TYF009/Mini-Printer/docs/en/index.md

# FOLI documentation

[简体中文](../zh-CN/index.md) · [Product overview](../../README.md)

| Guide | Purpose |
|---|---|
| [Get started](getting-started.md) | Explore the app, build software and prepare a compatible printer |
| [System architecture](architecture.md) | Follow layout, raster bytes, BLE, firmware and paper |
| [Mechanical and assembly](assembly.md) | Obtain printable parts and identify missing manufacturing details |
| [Verification](verification.md) | Understand recorded results and remaining integration limits |
| [Product case study](product-case-study.md) | See concrete product/engineering decisions and tradeoffs |
| [Sources and media](provenance.md) | Separate new work, inherited materials, visualization and evidence |

The older Chinese module notes in the parent documentation directory are retained as historical technical references. When they disagree with selected source files or the current verification record, resolve the discrepancy rather than assuming the newest-looking prose is correct.
