TYF009/Mini-Printer/docs/zh-CN/index.md

# FOLI 文档导航

[English](../en/index.md) · [产品首页](../../README.zh-CN.md)

| 文档 | 内容 |
|---|---|
| [开始使用](getting-started.md) | 体验 App、构建软件、准备兼容打印机 |
| [系统架构](architecture.md) | 排版、光栅、BLE、固件到纸张的链路 |
| [机械与装配](assembly.md) | 打印件、装配参考和待记录制造信息 |
| [验证范围](verification.md) | 已观察结果及尚未解决的联调边界 |
| [产品案例](product-case-study.md) | 具体产品／工程判断与取舍 |
| [来源与媒体](provenance.md) | 区分新增实现、既有资料、概念视觉和真实证据 |

上级目录的旧中文模块文档保留为历史技术参考。与选定源码或当前验证记录冲突时应核实差异，不能仅按文字更新时间判断正确性。
