TYF009/Mini-Printer/docs/03-软件设计/07-步进电机.md

# 03-软件设计 · 07 · 步进电机驱动

## 1. 需求

打印机逐行成像：打完一行 → 电机拖纸前进一个行高 → 打下一行 → 循环至整幅完成。走纸精度直接决定行距一致性（=图像纵向分辨率），所以用**步进电机**（开环精确定位），机芯电机为两相四线、额定 3.5~8.5V，由 TC1508S 双 H 桥驱动（硬件见 02-硬件设计/04）。

## 2. 步进原理：四相八拍

两相步进电机按励磁顺序通电，转子以固定步距角转动。本项目用**四相八拍（半步）**序列——把两相线圈按 8 状态循环励磁（A→AB→B→BC→C→CD→D→DA），每拍步距角为整步的一半：

```c
// em_motor.cpp：8 状态 × 4 引脚查表（INA/INB/INC/IND）
static const uint8_t step_table[8][4] = { {1,0,0,0},{1,1,0,0},{0,1,0,0},{0,1,1,0},
                                          {0,0,1,0},{0,0,1,1},{0,0,0,1},{1,0,0,1} };
```

每发一拍，依次把表项写到 4 个 IO 上，并保持足够的相稳定时间（本项目 2ms 节拍）。查表法把励磁序列固化，逻辑清晰且换向只需反转查表方向。

## 3. 走纸与打印的几何关系

- 步进电机每前进一步，纸张前进 **0.0625mm**
- **每 4 步 = 一个打印点的行高**（结构参数：4 × 0.0625 = 0.25mm 行距，对应 384 点热敏头的纵向 DPI）
- 所以"打印一行走一行"在代码里就是：每打完一行 `motor_step(4)`

## 4. 两种驱动方式（em_motor.cpp 提供）

| 方式 | 实现 | 场景 |
|---|---|---|
| Ticker 中断步进 | 2ms 定时器回调里走一拍 | 长按连续走纸（不阻塞按键扫描） |
| 同步步进 | 循环内逐拍走 + 相间延时 | 打印行间隙走纸（与打印时序强同步） |

打印时用同步方式（一行打完必须精确走 4 步再打下一行，时序强耦合）；用户手动走纸用中断方式（响应连续运转且不卡其他任务）。打印结束后固件还会连续走纸 230 步（~14mm）做"出纸收尾"，方便撕取。
