TYF009/Mini-Printer/docs/zh-CN/product-case-study.md

# FOLI：把完整产品讲清楚

[English](../en/product-case-study.md) · [文档导航](index.md)

FOLI 围绕已有 Mini-Printer 实物平台，建立英文优先的产品体验，将真实控制板与打印机构、嵌入式固件、现有外壳设计和新原生 Android App 连接起来。展示重点是跨软硬件的产品判断，并让别人能够理解与复现。

## 一个具体场景贯穿系统

键盘旁的一张清单便能串起整条链路：选模板、改文字、查看黑白效果、连接并发送、把纸条放在手边。礼物留言与随身清单复用相同能力，不依赖云端账号或复杂内容服务。

暖白、薄荷与纸面编辑器建立统一视觉。生活概念图表达预期体验，真实硬件照片说明电路与纸面输出确实存在；两类素材承担不同证据作用。

## 决策一：预览真正准备发送的内容

装饰预览可能很好看，却掩盖阈值、抖动和行宽造成的输出变化。FOLI 编码出 384 点光栅，再根据编码结果生成预览，使用户查看的是准备发送的数据表示。

代价是内容有界限，也确实需要处理时间。`PrinterProtocol` 检查宽度与行数，`PaperRenderer` 负责排版。生成下一次预览时保留上一张纸面，避免编辑区变空。实现见[系统架构](architecture.md)和 [Android 源码](../../software/android/app/src/main/java/studio/foli/android/)。

## 决策二：用旧手机暴露真实布局问题

小米 6 暴露了桌面大屏效果图看不到的问题：键盘挡住操作、复选框细线在二值化后缺失、反馈提示让编辑区域移动。实现因此采用全屏文字编辑、明确的复选框几何和不挤压纸面的反馈。

模板筛选、本地收藏、大预览、Cancel／Undo 与滚动位置保留减少了重复寻找上下文。它们是已实现的功能，并有部分真机观察；这不代表已经测得动画 FPS 或完成用户研究。实际检查范围见[验证记录](verification.md)。

## 决策三：把不确定当作产品状态

蓝牙连接、发送成功和打印完成不是同一事件。继承协议的端到端证据有限，因此 FOLI 分别显示传输与打印状态。即便观察到开始到终态的完整序列，也仅判为 STOPPED_UNCONFIRMED，因为状态3还可能表示异常停止。应用提示检查纸张，并在下一任务前重启打印机后明确确认，阻止盲目重发部分接收内容。

不确定传输后可能需要用户明确重启打印机。这不如自动重试方便，但在协议无法证明已打印内容时，可以避免悄悄重复或破坏实体任务。固件修复与未来协议升级也应维持这一区分。

## 仓库工作与成果边界

FOLI 阶段工作包括原生 Android 体验、模板编辑交互、光栅／协议整合、品牌、产品可视化和工程文档整合。已有硬件、固件与机械基础保留来源上下文。购买授权、上游作者与新增实现分别见[来源说明](provenance.md)。

项目按开发状态发布：有历史实物打印，有 App 交互与协议测试；没有重复验证全部更新组件的端到端纸面输出。下一步有价值的证据是最终整机照片、制造参数和版本化联调记录，而非虚构速度、耐久或量产成熟度。
