TYF009/Mini-Printer/docs/images/pcb-3d-bottom.png

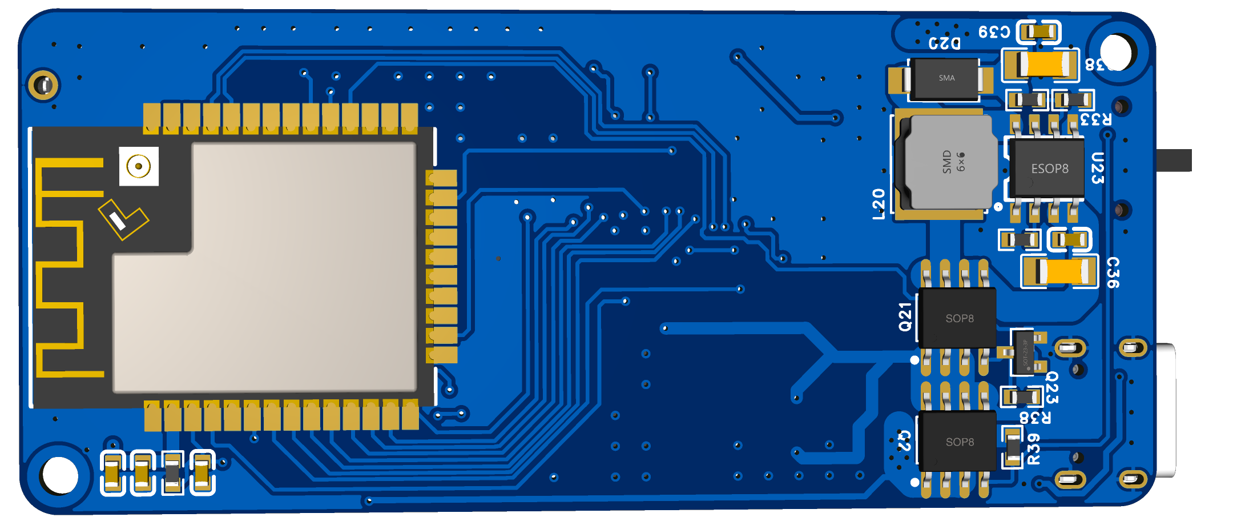
docs/images/pcb-3d-bottom.png
