TYF009/Mini-Printer/docs/images/pcb-3d-top.png

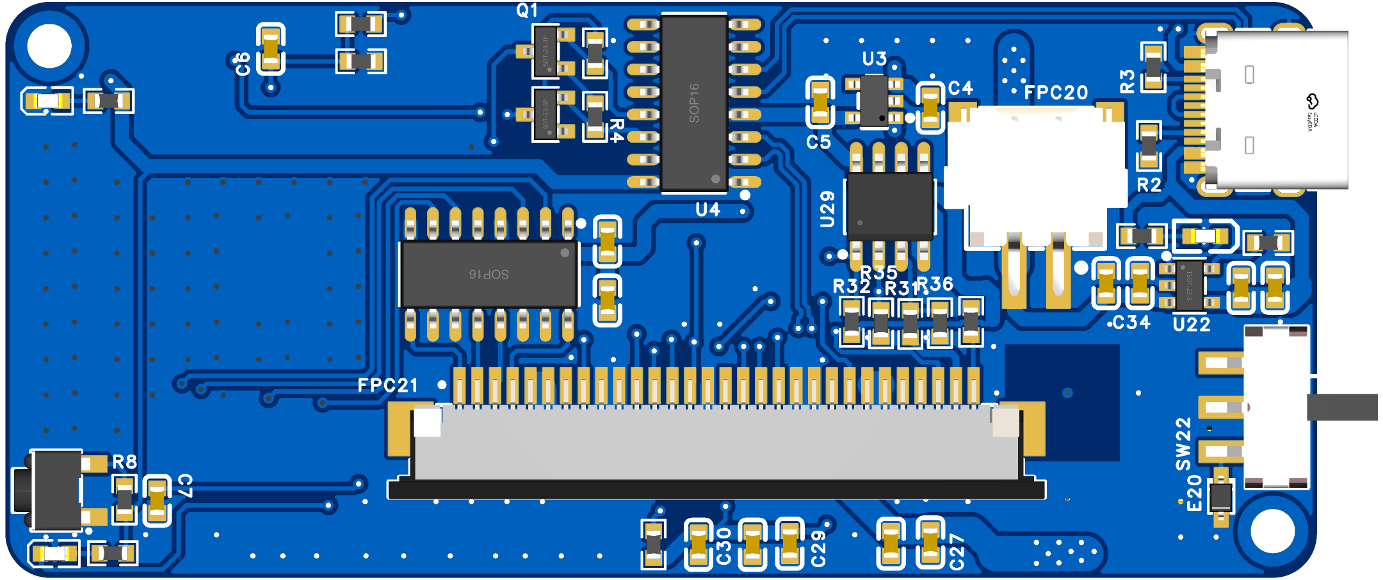
docs/images/pcb-3d-top.png
