TYF009/Mini-Printer/hardware/EDA-project/exports/schematic.png

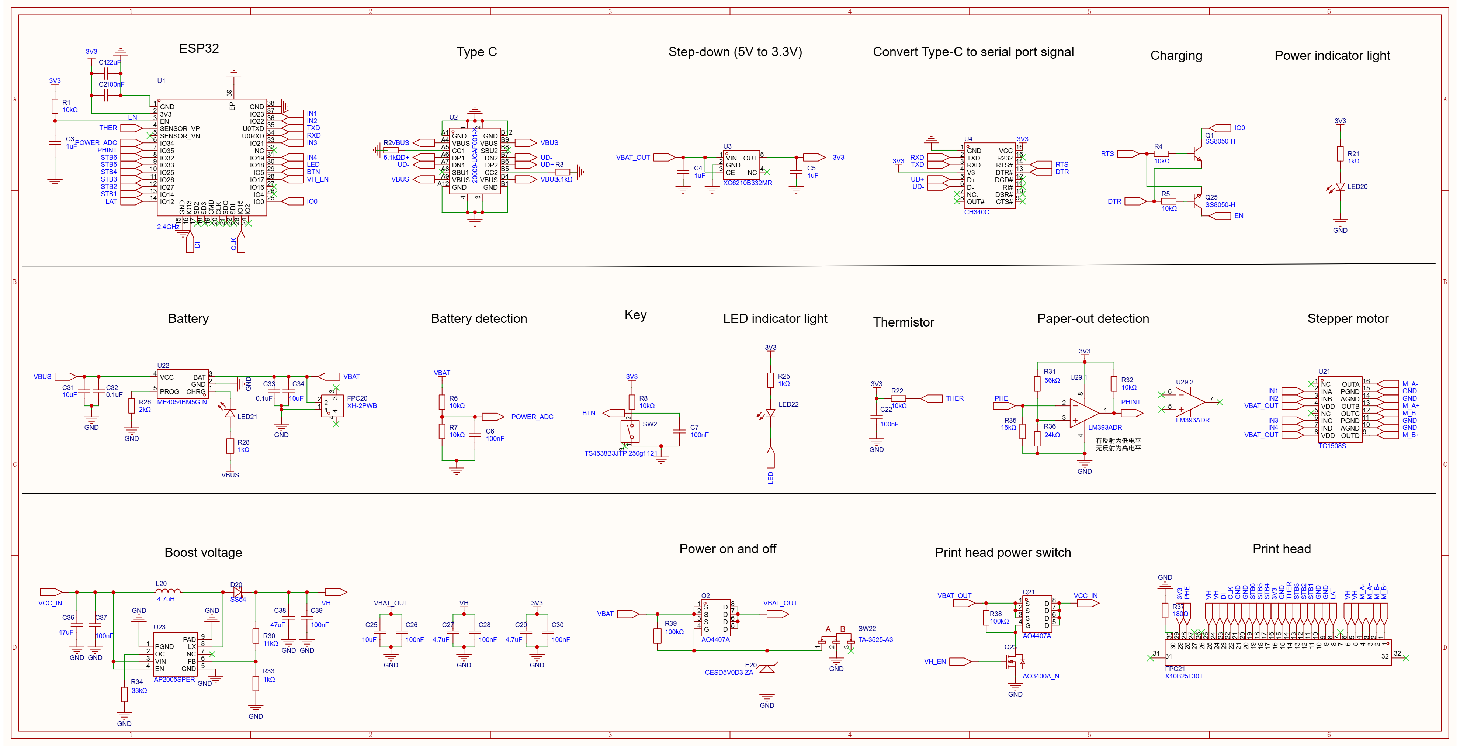
hardware/EDA-project/exports/schematic.png
