TYF009/Mini-Printer/media/gifs/screen-to-paper.gif

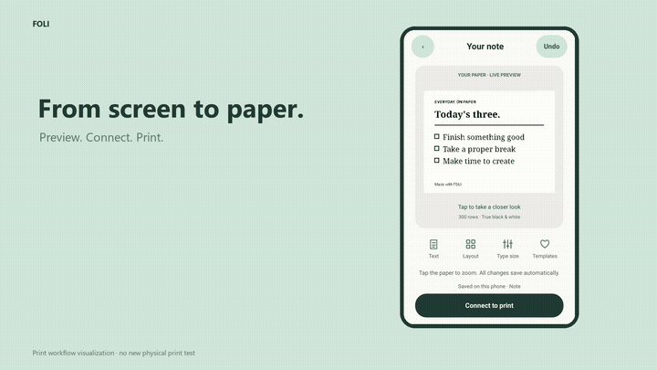
media/gifs/screen-to-paper.gif
