TYF009/Mini-Printer/media/images/app-overview.png

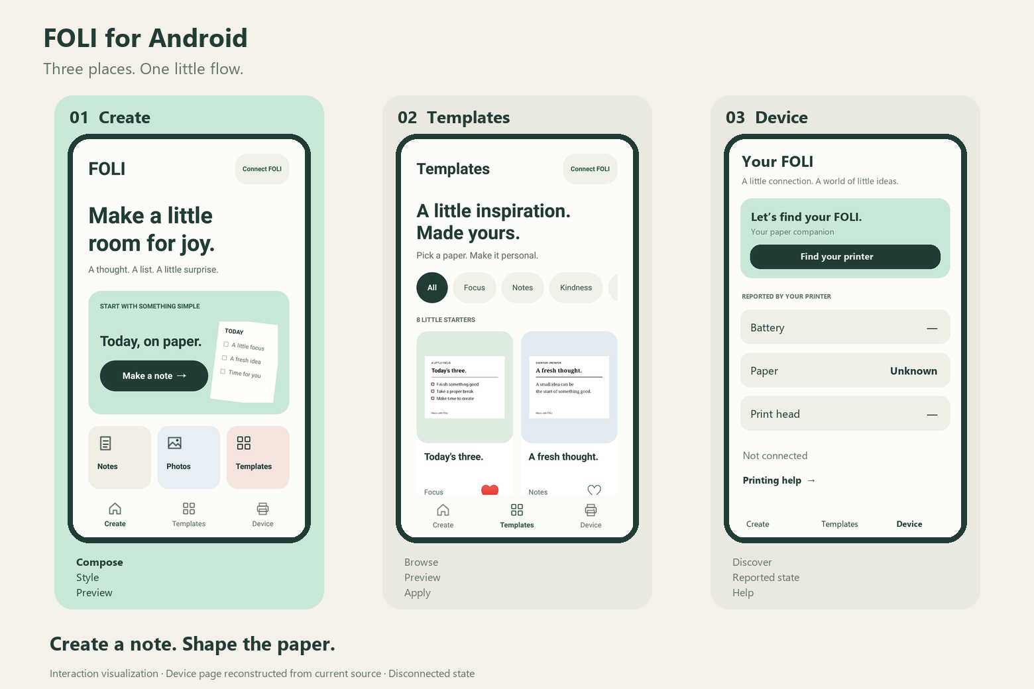
media/images/app-overview.png
