TYF009/Mini-Printer/media/source/assets/kindness.png

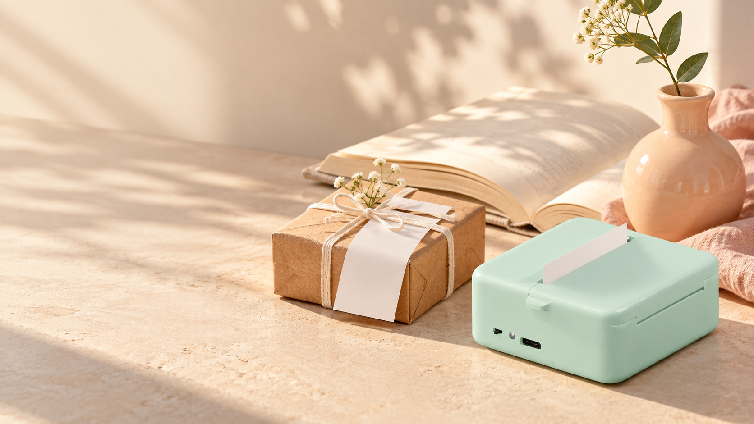
media/source/assets/kindness.png
