TYF009/Mini-Printer/media/source/assets/travel.png

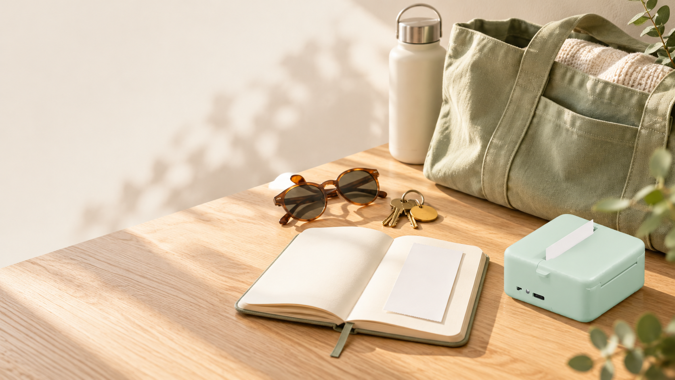
media/source/assets/travel.png
