TYF009/Mini-Printer/media/source/screens/android-v020/template_preview.png

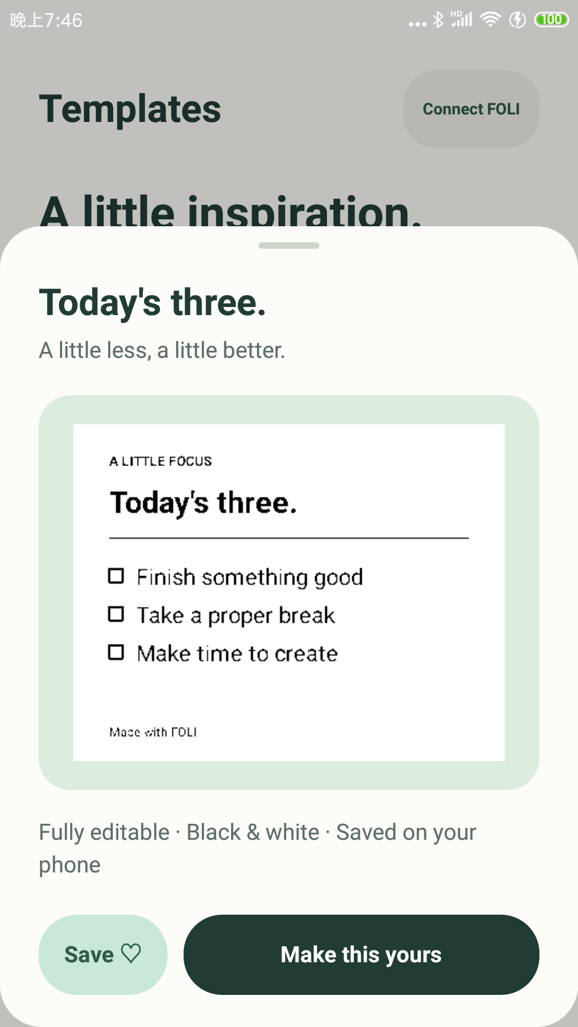
media/source/screens/android-v020/template_preview.png
