TYF009/Mini-Printer/hardware/EDA-project/exports/Mini-Printer-BOM.xlsx

No. | Quantity | Comment | Designator | Footprint | Value | Manufacturer Part | Manufacturer | Supplier Part | Supplier
1 | 1 | 22uF | C1 | C0603 | 22uF | CL10A226MQ8NRNC | SAMSUNG(三星) | C59461 | LCSC
2 | 3 | 100nF | C2,C6,C7 | C0603 | 100nF | CC0603KRX7R9BB104 | YAGEO(国巨) | C14663 | LCSC
3 | 3 | 1uF | C3,C4,C5 | C0603 | 1uF | CL10A105KB8NNNC | SAMSUNG(三星) | C15849 | LCSC
4 | 6 | 100nF | C22,C26,C28,C30,C37,C39 | C0603 | 100nF | CL10B104KB8NNNC | SAMSUNG(三星) | C1591 | LCSC
5 | 3 | 10uF | C25,C31,C34 | C0603 | 10uF | CL10A106MA8NRNC | SAMSUNG(三星) | C96446 | LCSC
6 | 2 | 4.7uF | C27,C29 | C0603 | 4.7uF | CL10A475KA8NQNC | SAMSUNG(三星) | C69335 | LCSC
7 | 2 | 0.1uF | C32,C33 | c0603 | 0.1uF | MT18N1R5C500CT | 华新科(Walsin) | C14663 | LCSC
8 | 2 | 47uF | C36,C38 | C1206 | 47uF | CL31A476MPHNNNE | SAMSUNG(三星) | C96123 | LCSC
9 | 1 | SS54 | D20 | SMA_L4.3-W2.6-LS5.0-RD |  | SS54 | TWGMC(台湾迪嘉) | C727065 | LCSC
10 | 1 | CESD5V0D3 ZA | E20 | SOD-323_L1.8-W1.3-LS2.5-RD |  | CESD5V0D3 ZA | CJ(江苏长电/长晶) | C22643 | LCSC
11 | 1 | XH-2PWB | FPC20 | CONN-SMD_2P-P2.50_DEALON_XH-2PWB_C2905024 |  | XH-2PWB | DEALON(德艺隆) | C2905024 | LCSC
12 | 1 | X10B25L30T | FPC21 | FPC-SMD_X10B25U30T |  | X10B25L30T | XKB Connectivity(中国星坤) | C500182 | LCSC
13 | 1 | 4.7uH | L20 | IND-SMD_L6.0-W6.0 | 4.7uH | 1255AY-4R7M=P3 | muRata(村田) | C160951 | LCSC
14 | 2 | NCD0603R1 | LED20,LED22 | LED0603-RD_RED |  | NCD0603R1 | 国星光电 | C84263 | LCSC
15 | 1 | TLMG1100-GS08 | LED21 | LED0603-R-RD_GREEN |  | TLMG1100-GS08 | VISHAY(威世) | C241891 | LCSC
16 | 2 | SS8050-H | Q1,Q25 | SOT-23-3_L2.9-W1.3-P1.90-LS2.4-BR |  | SS8050-H | YANGJIE(扬杰) | C699255 | LCSC
17 | 2 | AO4407A | Q2,Q21 | SOP-8_L5.0-W4.0-P1.27-LS6.0-BL |  | AO4407A | UMW(友台半导体) | C2841482 | LCSC
18 | 1 | AO3400A_N | Q23 | SOT-23-3_L2.9-W1.3-P1.90-LS2.4-BR |  | AO3400A | UMW(友台半导体) | C347475 | LCSC
19 | 8 | 10kΩ | R1,R4,R5,R6,R7,R8,R22,R32 | R0603 | 10kΩ | 0603WAF1002T5E | UNI-ROYAL(厚声) | C25804 | LCSC
20 | 2 | 5.1kΩ | R2,R3 | R0603 | 5.1kΩ | 0603WAF5101T5E | UNI-ROYAL(厚声) | C23186 | LCSC
21 | 3 | 1kΩ | R21,R25,R33 | R0603 | 1kΩ | RMC06031K1%N | Tyohm(幸亚电阻) | C269704 | LCSC
22 | 1 | 2kΩ | R26 | R0603 | 2kΩ | 0603WAF2001T5E | UNI-ROYAL(厚声) | C22975 | LCSC
23 | 1 | 1kΩ | R28 | R0603 | 1kΩ | ERA3VEB1001V | PANASONIC(松下) | C490794 | LCSC
24 | 1 | 11kΩ | R30 | R0603 | 11kΩ | 0603WAJ0113T5E | UNI-ROYAL(厚声) | C25983 | LCSC
25 | 1 | 56kΩ | R31 | R0603 | 56kΩ | 0603WAF5602T5E | UNI-ROYAL(厚声) | C23206 | LCSC
26 | 1 | 33kΩ | R34 | R0603 | 33kΩ | 0603WAF3302T5E | UNI-ROYAL(厚声) | C4216 | LCSC
27 | 1 | 15kΩ | R35 | R0603 | 15kΩ | 0603WAF1502T5E | UNI-ROYAL(厚声) | C22809 | LCSC
28 | 1 | 24kΩ | R36 | R0603 | 24kΩ | 0603WAF2402T5E | UNI-ROYAL(厚声) | C23352 | LCSC
29 | 1 | 180Ω | R37 | R0603 | 180Ω | 0603WAF1800T5E | UNI-ROYAL(厚声) | C22828 | LCSC
30 | 1 | 100kΩ | R38 | R0603 | 100kΩ | 0603WAF1003T5E | UNI-ROYAL(厚声) | C25803 | LCSC
31 | 1 | 100kΩ | R39 | R0603 | 100kΩ | ERA3VEB1003V | PANASONIC(松下) | C490798 | LCSC
32 | 1 | TS4538B3JTP 250gf 121 | SW2 | KEY-SMD_3P-L4.5-W3.8-P3.00-LS4.5-BL |  | TS4538B3JTP 250gf 121 | SHOU HAN(首韩) | C2906367 | LCSC
33 | 1 | TA-3525-A3 | SW22 | SW-SMD_3P-L9.1-W3.5-P2.50-EH6.8 |  | TA-3525-A3 | Yuandi(元迪) | C514020 | LCSC
34 | 1 | 2.4GHz | U1 | WIRELM-SMD_ESP32-S | 2.4GHz | ESP32-S | Ai-Thinker(安信可) | C277944 | LCSC
35 | 1 | 20009-UCAF001-X | U2 | TYPE-C-SMD_20009-UCAF001-X |  | 20009-UCAF001-X | MINTRON(明硕) | C3148200 | LCSC
36 | 1 | XC6210B332MR | U3 | SOT-23-5_L2.9-W1.6-P0.95-LS2.8-BR |  | XC6210B332MR | TECH PUBLIC(台舟) | C3021084 | LCSC
37 | 1 | CH340C | U4 | SOP-16_L10.0-W3.9-P1.27-LS6.0-BL |  | CH340C | WCH(南京沁恒) | C84681 | LCSC
38 | 1 | TC1508S | U21 | SOP-16_L10.0-W3.9-P1.27-LS6.0-BL |  | TC1508S | FM富满 | C89480 | LCSC
39 | 1 | ME4054BM5G-N | U22 | TSOT-23-5_L2.9-W1.6-P0.95-LS2.8-BL |  | ME4054BM5G-N | MICRONE(南京微盟) | C478383 | LCSC
40 | 1 | AP2005SPER | U23 | ESOP-8_L4.9-W3.9-P1.27-LS6.0-BL-EP |  | AP2005SPER | chipown(芯朋微电子) | C130340 | LCSC
41 | 1 | LM393ADR | U29 | SOP-8_L4.9-W3.9-P1.27-LS6.0-BL |  | LM393ADR | UMW(广东友台半导体) | C404321 | LCSC
