TYF009/Mini-Printer/mechanical/stl/body.stl

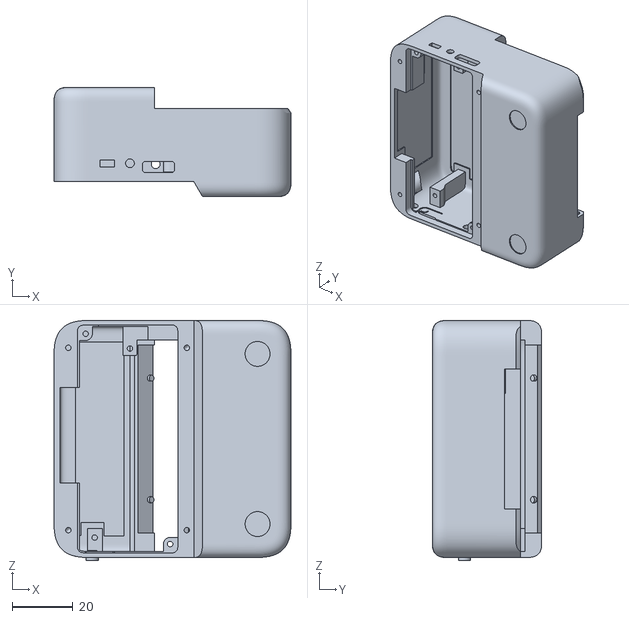
[picture p34: CAD file, 2026-10-29]
mechanical/stl/body.stl
78.0 x 36.0 x 79.0
