TYF009/Mini-Printer/mechanical/stl/lower-cover.stl

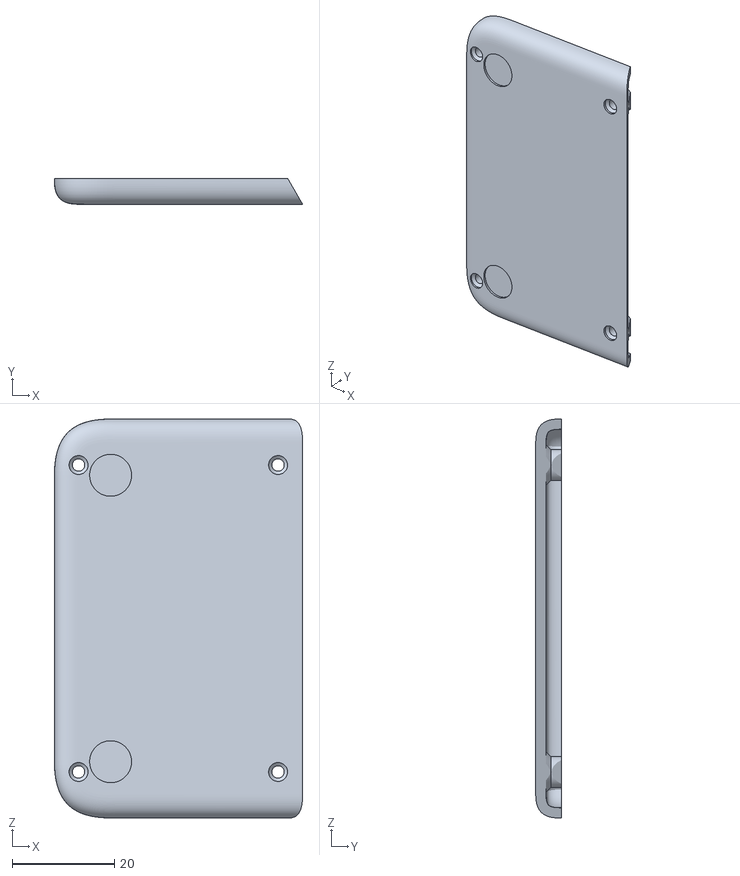
[picture p35: CAD file, 2026-10-29]
mechanical/stl/lower-cover.stl
48.5 x 5.00 x 78.0
