TYF009/Mini-Printer/mechanical/stl/retainer.stl

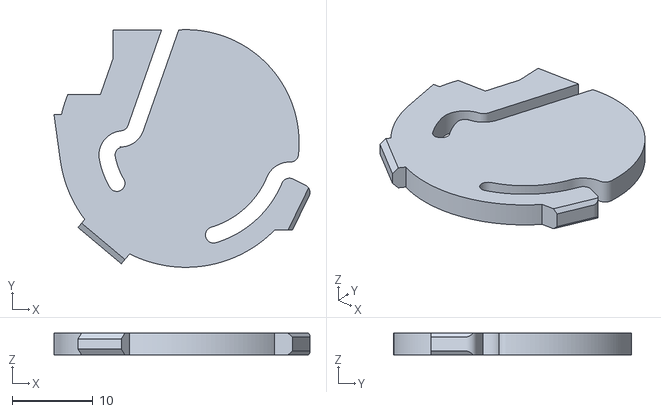
[picture p36: CAD file, 2026-10-29]
mechanical/stl/retainer.stl
31.7 x 29.4 x 2.70
