TYF009/Mini-Printer/docs/zh-CN/assembly.md

# 机械文件与装配准备

[English](../en/assembly.md) · [文档导航](index.md)

带标注的 CAD 展开图

外壳资料基于 2023-09-18 装配体。展开图说明部件关系，不代表已验证的逐步装配流程、配合公差或上盖实际运动方式。

## 打印件

| 零件 | 文件 |
|---|---|
| 外壳主体 | [body.stl](../../mechanical/stl/body.stl) |
| 上盖 | [upper-cover.stl](../../mechanical/stl/upper-cover.stl) |
| 下盖 | [lower-cover.stl](../../mechanical/stl/lower-cover.stl) |
| 卡板 | [retainer.stl](../../mechanical/stl/retainer.stl) |

原文件日期为：主体 230727，上盖、下盖、卡板 230719。完整 STEP 约 224 MB，与轻量展示媒体分开管理；完整装配体是否随克隆提供，以机械下载/来源说明为准。

## 用户提供的装配参考

以下数量来自视觉 BOM，仅供参考；采购前应与最终结构版本核对。

| 配件 | 数量 |
|---|---:|
| 控制板、主体、上盖、下盖、卡板 | 各 1 |
| M3 × 6.4 mm 导光柱 | 3 |
| M2 × 10 沉头自攻螺丝 | 4 |
| M2 × 8 盘头自攻螺丝 | 4 |
| M2 × 6 滚花轴 | 2 |
| 齿刀 | 1 |
| 脚垫 | 4 |
| 打印机构 | 1 |
| 电池 | 1 |
| 57 × 30 打印纸参考卷 | 1 |

电池出线为 XH 2.54 mm 2P，用户指定倍率 5C。容量、极性、实物尺寸和准确采购型号需要匹配实际硬件；结构 BOM 不能代替电气 BOM。

## 装配准备流程

1. 在 CAD／切片软件中检查四个 STL 和装配体，确认单位、零件尺寸与版本对应后再切片。
2. 对照实物核对 PCB 外形、安装孔、接口开口与走纸路径。独立 STL 使用不同局部坐标，不能按原点直接判断装配位置。
3. 紧固前试装主体、控制板和打印机构。布线和安装机构时断开电池，FPC 与连接器方向以最终电路设计为准。
4. 参考原装配体确认导光柱、齿刀、轴和卡板位置。螺丝位置与进入深度须结合模型核对，数量表并不说明每颗螺丝安装在哪里。
5. 检查纸卷、走纸路径、上盖与齿刀是否干涉，记录纸卷方向与最终装配照片。
6. 改变装配方案后，依选定硬件／固件验证流程确认，不以试装成功替代完整资格验证。

## 尚未记录的制造信息

现有记录没有核实耗材、喷嘴、层高、壁数、支撑、摆放方向、收缩补偿或配合公差。配色渲染不是材料规格。后续打印外壳时应一并记录打印机型号、结构版本、切片参数和试装结果。

仓库提供几何源文件与装配参考，当前不将其称为生产制造包。历史实物打印和当前软件检查的范围见[验证记录](verification.md)。
