TYF009/Mini-Printer/media/source/evidence/print-test-page.jpg

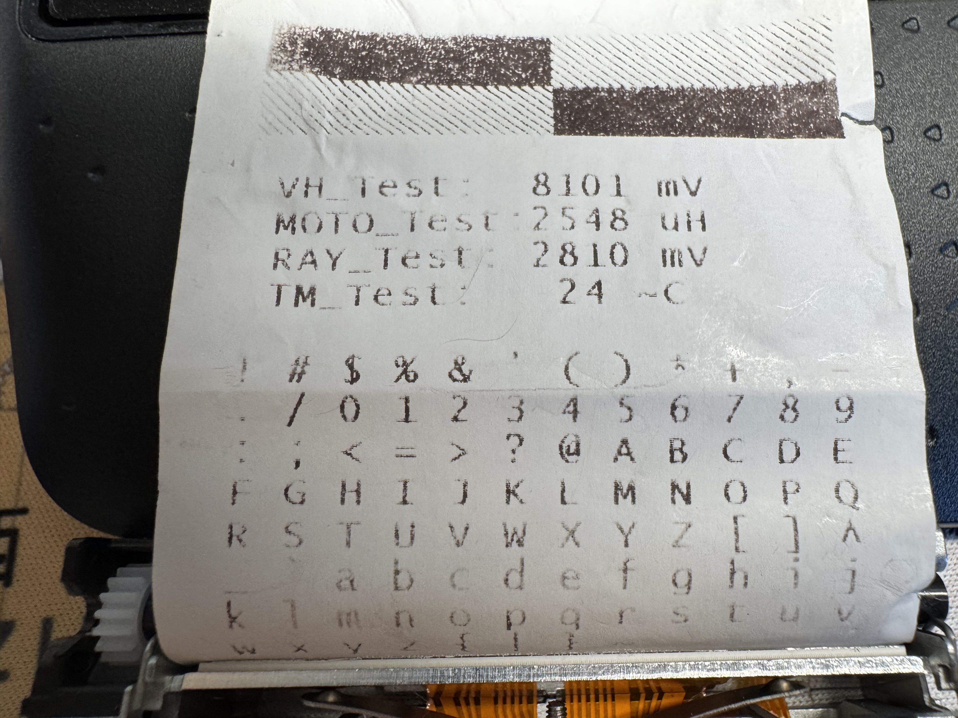
media/source/evidence/print-test-page.jpg
