TYF009/Mini-Printer/software/android/verification/evidence/editor-final.png

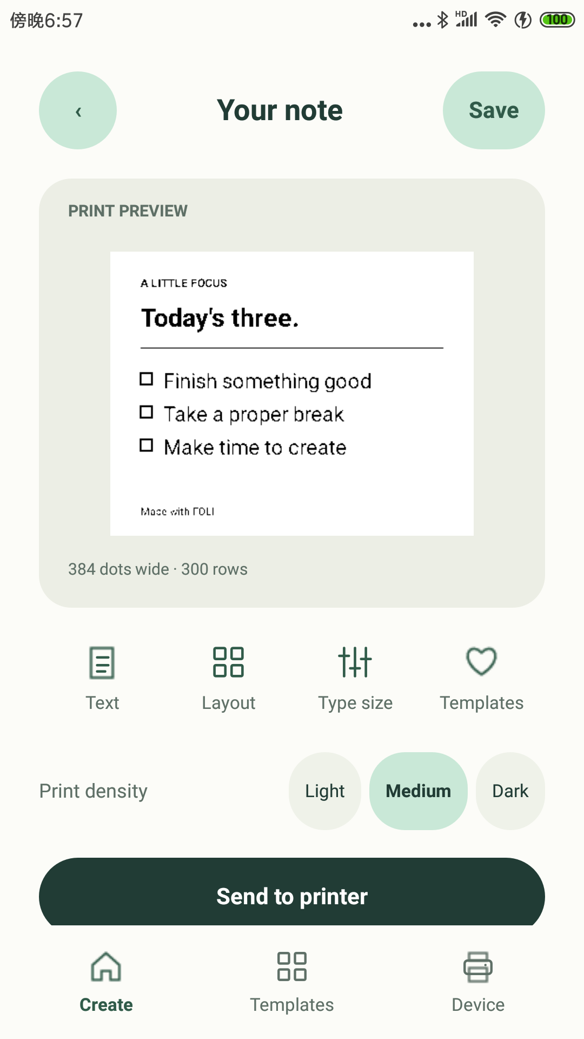
software/android/verification/evidence/editor-final.png
