TYF009/Mini-Printer/software/android/verification/evidence/final_gallery.png

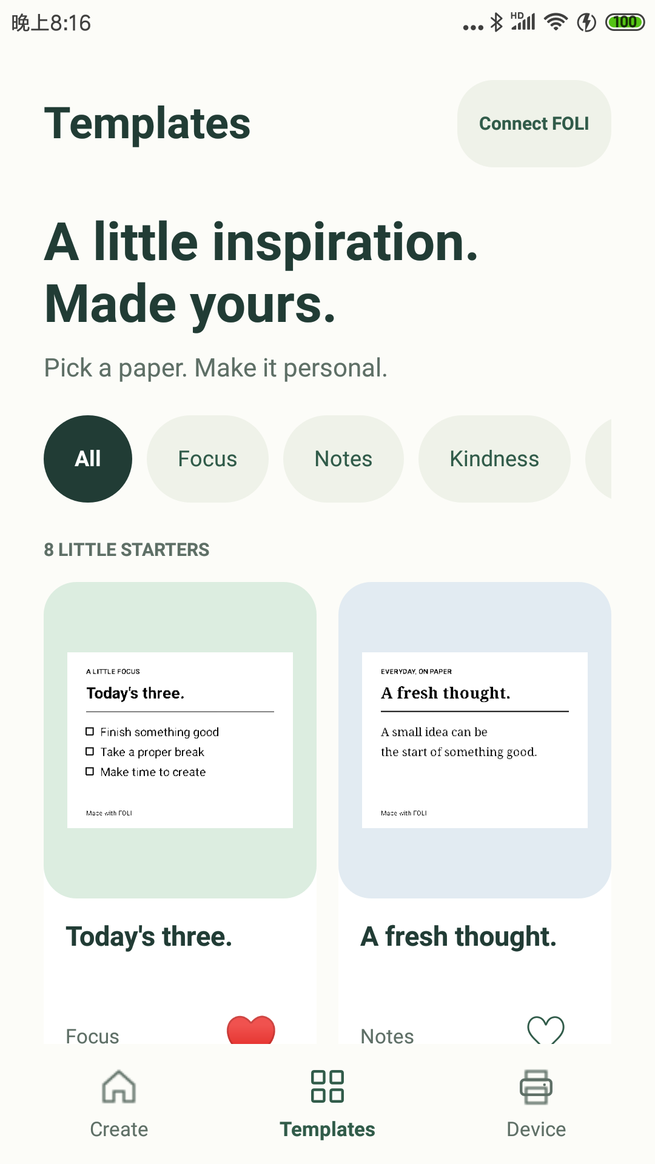
software/android/verification/evidence/final_gallery.png
