TYF009/Mini-Printer/software/android/verification/evidence/templates-final.png

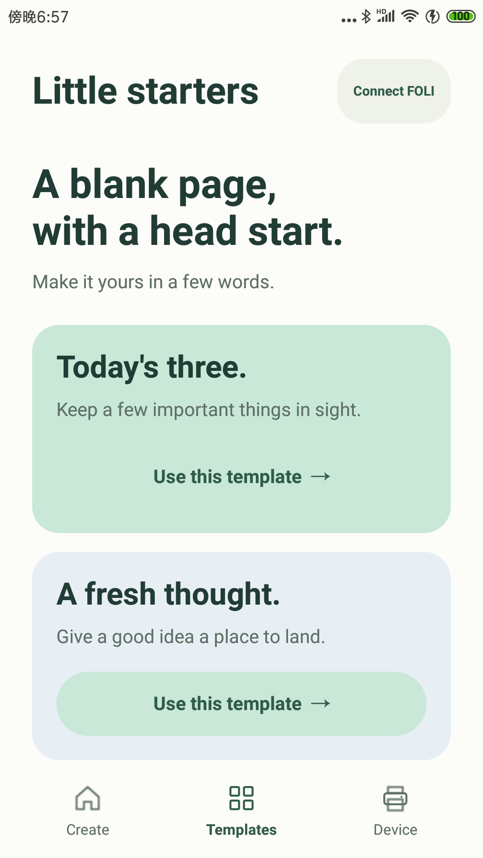
software/android/verification/evidence/templates-final.png
