TYF009/Mini-Printer/media/source/screens/android-v020/journal_live.png

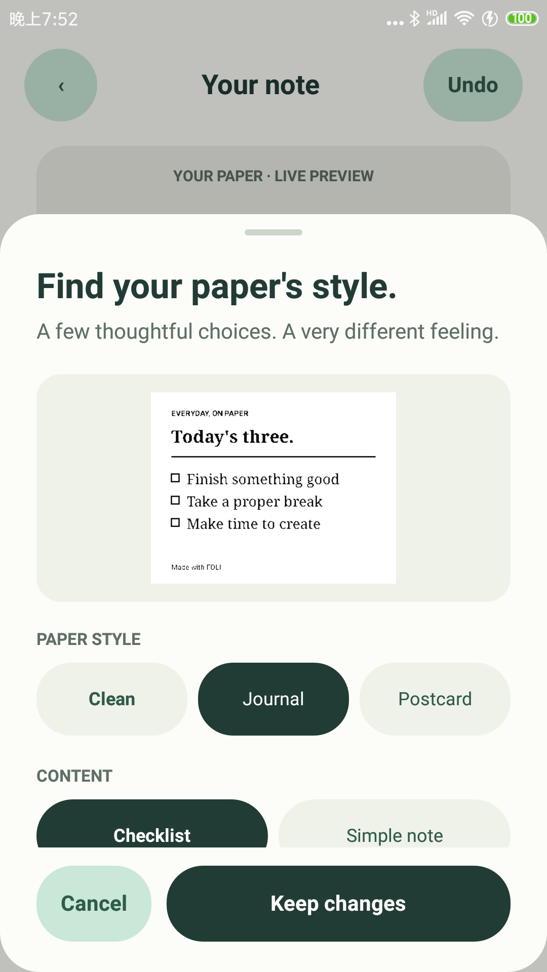
media/source/screens/android-v020/journal_live.png
