TYF009/Mini-Printer/software/firmware/src/em_task.cpp

#include "em_task.h"
#include "hal/em_button.h"
#include "hal/em_motor.h"
#include "hal/em_printer.h"
#include "hal/em_adc.h"

volatile bool printer_test = false;

void key_click_handle()
{
    Serial.print("Key 单击!");
    printer_test = true;
    // read_all_hal();
}

void key_long_click_handle()
{
    Serial.print("Key 长按!");
    device_state_t *pdevice = get_device_state();
    bool need_beep = false;
    // 不缺纸且不在打印中才执行
    if (pdevice->paper_state == PAPER_STATUS_NORMAL)
    {
        if (pdevice->printer_state == PRINTER_STATUS_FINISH ||
            pdevice->printer_state == PRINTER_STATUS_INIT)
        {
            Serial.print("开始走纸\n");
            motor_start();
        }
        else
        {
            need_beep = true;
        }
    }
    else
        need_beep = true;
    if (need_beep)
    {
        run_beep(BEEP_WARN);
        run_led(LED_WARN);
    }
}

void key_long_click_free_handle()
{
    Serial.print("停止走纸\n");
    motor_stop();
}


/**
 * @brief 处理上报相关事件
 *
 */
void run_report()
{
    if (get_state_timeout())
    {
        clean_state_timeout();
        read_all_hal();
        if (get_ble_connect())
        {
            Serial.print("report device status ： report time up\n");
            ble_report();
        }
    }
    if (read_paper_irq_need_report_status())
    {
        // 缺纸中断产生，需要上报
        Serial.print("report device status : paper irq\n");
        ble_report();
    }
}

/**
 * @brief 处理打印相关事件
 *
 */
void run_printer()
{
    device_state_t *pdevice = get_device_state();
    #if START_PRINTER_WHEN_FINISH_RAED
        if (pdevice->read_ble_finish == true)
        {
            if (pdevice->printer_state == PRINTER_STATUS_FINISH ||
                pdevice->printer_state == PRINTER_STATUS_INIT)
            {
                pdevice->read_ble_finish = false;
                pdevice->printer_state = PRINTER_STATUS_START;
                ble_report();
                Serial.printf("report device status : printing start %d\n",get_ble_rx_leftline());
                run_beep(BEEP_PRINTER_START);
                run_led(LED_PRINTER_START);
            }
        }
    #else
    // 接收大于100条时，才触发开始打印
    if (get_ble_rx_leftline()> 100)
    {
        if (pdevice->printer_state == PRINTER_STATUS_FINISH ||
            pdevice->printer_state == PRINTER_STATUS_INIT)
        {
            pdevice->printer_state = PRINTER_STATUS_START;
            ble_report();
            Serial.print("report device status : printing start\n");
            run_beep(BEEP_PRINTER_START);
            run_led(LED_PRINTER_START);
        }
    }
    #endif
    // 开始打印
    if (pdevice->printer_state == PRINTER_STATUS_START)
    {
        // 正常打印
        start_printing_by_queuebuf();
        pdevice->printer_state = PRINTER_STATUS_FINISH;
        ble_report();
    }
}

void task_report(void *pvParameters)
{
    for (;;) // A Task shall never return or exit.
    {
        run_report();
        vTaskDelay(pdMS_TO_TICKS(100));
    }
}

void task_button(void *pvParameters)
{
    for (;;) // A Task shall never return or exit.
    {
        key_check_run(); // 需要周期调用按键处理函数
        vTaskDelay(pdMS_TO_TICKS(10));
    }
}

void printer_run(){
    for (;;) // A Task shall never return or exit.
    {
        run_printer();
        vTaskDelay(1); // At least one scheduler tick, even with a coarse tick rate.
        if(printer_test){
            printer_test = false;
            get_device_state()->printer_state=PRINTER_STATUS_START;
            testSTB();
            get_device_state()->printer_state=PRINTER_STATUS_FINISH;
            ble_report();
        }
    }
}

void init_task()
{
    Serial.begin(115200);
    Serial.print("init_task\n");
    Serial.print("--mini printer V1.0.3--\n");
    init_device_state();
    init_timer();
    init_hal();
    init_queue();
    adc_init();
    init_ble();
    init_key();
    init_printer();
    xTaskCreate(
        task_report,  // 任务函数
        "TaskReport", // 任务名
        1024*10,         // 任务栈
        NULL,         // 任务参数
        1,            // 任务优先级, with 3 (configMAX_PRIORITIES - 1) 是最高的，0是最低的.
        NULL          // 任务句柄
    );

    xTaskCreate(
        task_button,  // 任务函数
        "TaskButton", // 任务名
        1024*5,         // 任务栈
        NULL,         // 任务参数
        0,            // 任务优先级, with 3 (configMAX_PRIORITIES - 1) 是最高的，0是最低的.
        NULL          // 任务句柄
    );
}
