TYF009/Mini-Printer/software/firmware/src/hal/em_adc.cpp

#include "em_config.h"
#include "utils/temperature.h"



void adc_init() {
  pinMode(PIN_ADC_EN, OUTPUT);
  analogReadResolution(BATTERY_ADC_BIT);
  digitalWrite(PIN_ADC_EN, HIGH);
}

void adc_test() {
  // read the analog / millivolts value for pin 2:
  int analogValue = analogRead(PIN_BATTERY_ADC);
  int analogVolts = analogReadMilliVolts(PIN_BATTERY_ADC);
  // print out the values you read:
  Serial.printf("ADC analog value = %d\n",analogValue);
  Serial.printf("ADC millivolts value = %d\n",analogVolts);
}

/**
 * @brief 获取ADC引脚电压值，可根据需要加入滤波算法
 *
 * @return int
 */
int get_adc_volts(){
    // int analogValue = analogRead(PIN_BATTERY_ADC);
    // Serial.printf("ADC analog value = %d volts = %d\n",analogValue,analogValue*2.6/4095.0);
    int analogVolts = analogReadMilliVolts(PIN_BATTERY_ADC);
    Serial.printf("ADC millivolts value = %d\n",analogVolts);
    return analogVolts;
}

/**
 公式法：
NTC 热敏电阻温度计算公式：Rt = Rp *EXP(B*(1/T1-1/T2))
可以得到温度T1与电阻Rt的关系T1=1/（log（Rt/Rp）/B+1/T2）

T1和T2指的是K度，即开尔文温度,K度=273.15(绝对温度)+摄氏度。
T2=(273.15+25)
Rt 是热敏电阻在T1温度下的阻值。
Rp 是热敏电阻在T2常温下的标称阻值。100K的热敏电阻25℃的值为100K（即R=100K）。T2=(273.15+25)
B值是热敏电阻的重要参数  B25/50= 3950K ±1%
最终对应的摄氏温度t=T1-273.15,同时+0.5的误差矫正。

查表法：
ADC采样率8位 串联电阻R1=10K R2=热敏电阻 电压3.3V
已知
Rt = R*(3.3-VR)/VR
VR = 3.3*ADC_Value/1024
得出
ADC_Value = VR*4096/3.3 =3.3*R/(Rt+R)*4096/3.3 = R/(Rt+R)*1024
ADC_Value=3.3/(C5+10)*10/3.3*1023
如果需要用到小数点后面的温度，正确的方法是使用公式RT＝R0*exp(B (1/T-1/T0))在excel中计算得到步进值为0.1℃的温度表
Rt=100*exp(3950*(1/(273.15+T1)-1/(273.15+25)))
Rt=100*EXP(3990*(1/(273.15+T1)-1/(273.15+25)))
*/

/**
 * @brief 阻值转换温度
 *
 * @param Rt 热敏电阻阻值
 * @return float 返回摄氏度温度
 */
float em_temp_calculate(float Rt)
{
    float Rp = 30000; // 30k
    float T2 = 273.15 + 25;
    float Bx = 3950; // B值
    float Ka = 273.15;
    float temp = 0.0f;

    temp = 1 / (log(Rt / Rp) / Bx + 1 / T2) - Ka + 0.5;
    return temp;
}

/**
 * @brief Get the adc temperatrue object
 *
 * @return float
 */
float get_adc_temperatrue(){
  const int raw=analogRead(PIN_TEMPERATRUE);
  if(raw<=0 || raw>=4095)return NAN;
  return foli::ntc_celsius(float(analogReadMilliVolts(PIN_TEMPERATRUE)));
}

void em_adc_test(){
  float Rt=0;
  float vol=3.0f;
  Rt=(vol*10000)/(3.3-vol);
  Serial.printf("Rt = %f\n",Rt);

  Rt = 60000; //60k 10°C
  float temp = 0.0f;
  temp = em_temp_calculate(Rt);
  Serial.printf("temp = %f\n",temp);

  if(temp >= 1e-7){
      Serial.printf("正\n");
  }else{
      Serial.printf("负\n");
  }
}
