TYF009/Mini-Printer/software/firmware/src/hal/em_ble.cpp

#include "em_ble.h"
#include "em_printer.h"
#include "utils/print_protocol.h"

BLECharacteristic *pCharacteristic = NULL;
bool bleConnected = false;
uint32_t packcount = 0;
static bool ordinaryWriteDispatch=false;

void clean_blepack_count(){
    packcount = 0;
}

uint32_t get_blepack_count(){
    return packcount;
}

bool get_ble_connect(){
    return bleConnected;
}

void ble_report(){
    if (get_ble_connect()){
        device_state_t *pdevice = get_device_state();
        uint8_t status[4];
        status[0] = pdevice->battery;
        status[1] = pdevice->temperature;
        status[2] = pdevice->paper_state;
        status[3] = pdevice->printer_state;
        pCharacteristic->setValue((uint8_t*)&status,sizeof(status));
        pCharacteristic->notify();
    }
}

// Server回调函数声明
class bleServerCallbacks : public BLEServerCallbacks
{
    void onConnect(BLEServer *pServer)
    {
        bleConnected = true;
        packcount = 0;
        Serial.println("现在有设备接入~");
        run_beep(BEEP_CONNECT);
        run_led(LED_CONNECT);
    }

    void onDisconnect(BLEServer *pServer)
    {
        bleConnected = false;
        Serial.println("现在有设备断开连接~");
        if(get_device_state()->printer_state!=PRINTER_STATUS_START && get_device_state()->printer_state!=PRINTER_STATUS_WORKING) { clean_printbuffer();set_read_ble_finish(false); }
        // 在有设备接入后Advertising广播会被停止，所以要在设备断开连接时重新开启广播
        // 不然的话只有重启ESP32后才能重新搜索到
        pServer->startAdvertising(); // 该行效果同 BLEDevice::startAdvertising();
    }
};

class bleCharacteristicCallbacks : public BLECharacteristicCallbacks
{
public:
    void onRead(BLECharacteristic *pCharacteristic)
    { // 客户端读取事件回调函数
        Serial.println("触发读取事件");
    }

    void onWrite(BLECharacteristic *characteristic, esp_ble_gatts_cb_param_t* param) override
    {
        // The library also invokes this overload for EXEC_WRITE with a different union member.
        // Parse only when the event-aware dispatcher below explicitly authorizes a normal write.
        if(!ordinaryWriteDispatch || !param || param->write.is_prep || param->write.offset!=0 ||
           param->write.handle!=characteristic->getHandle())return;
        size_t length=param->write.len;
        uint8_t* pdata=param->write.value;
        if(!pdata || !length)return;
        device_state_t* state=get_device_state();
        if(state->printer_state==PRINTER_STATUS_START || state->printer_state==PRINTER_STATUS_WORKING || state->read_ble_finish) return;
        const auto command=foli::classify(pdata,length);
        if(command==foli::Command::Density) {
            set_heat_density(pdata[4]==1?30:pdata[4]==2?60:100);
            return;
        }
        if(command==foli::Command::Finish) {
            if(printbuffer_complete())set_read_ble_finish(true);
            else { clean_printbuffer();clean_blepack_count();Serial.println("Rejected incomplete or overflowed print"); }
            return; // Command bytes must never enter the raster queue.
        }
        if(write_to_printbuffer(pdata,length))++packcount;

    }
};

static bleCharacteristicCallbacks applicationCallbacks;
static void applicationGattsEvent(esp_gatts_cb_event_t event, esp_gatt_if_t, esp_ble_gatts_cb_param_t* param) {
    if(!param || !pCharacteristic)return;
    if(event==ESP_GATTS_EXEC_WRITE_EVT) {
        // Prepared writes are unsupported. Never reinterpret exec_write as write.
        if(get_device_state()->printer_state!=PRINTER_STATUS_START && get_device_state()->printer_state!=PRINTER_STATUS_WORKING) {
            clean_printbuffer();set_read_ble_finish(false);clean_blepack_count();
        }
        return;
    }
    if(event!=ESP_GATTS_WRITE_EVT || param->write.handle!=pCharacteristic->getHandle())return;
    if(param->write.is_prep || param->write.offset!=0) {
        if(get_device_state()->printer_state!=PRINTER_STATUS_START && get_device_state()->printer_state!=PRINTER_STATUS_WORKING) {
            clean_printbuffer();set_read_ble_finish(false);clean_blepack_count();
        }
        return;
    }
    // Arduino-ESP32 2.0.17 dispatches this custom handler after its characteristic callback.
    ordinaryWriteDispatch=true;
    applicationCallbacks.onWrite(pCharacteristic,param);
    ordinaryWriteDispatch=false;
}

void init_ble()
{
    BLEDevice::init(BLE_NAME); // 填写自身对外显示的蓝牙设备名称，并初始化蓝牙功能
    BLEDevice::startAdvertising();   // 开启Advertising广播

    BLEServer *pServer = BLEDevice::createServer();  // 创建服务器
    pServer->setCallbacks(new bleServerCallbacks()); // 绑定回调函数

    BLEService *pService = pServer->createService(SERVICE_UUID); // 创建服务
    pCharacteristic = pService->createCharacteristic(            // 创建特征
        CHARACTERISTIC_UUID,
        BLECharacteristic::PROPERTY_READ |
            BLECharacteristic::PROPERTY_NOTIFY |
            BLECharacteristic::PROPERTY_WRITE |
            BLECharacteristic::PROPERTY_WRITE_NR);
    // 如果客户端连上设备后没有任何写入的情况下第一次读取到的数据应该是这里设置的值
    pCharacteristic->setCallbacks(&applicationCallbacks);
    BLEDevice::setCustomGattsHandler(applicationGattsEvent);
    pCharacteristic->addDescriptor(new BLE2902()); // 添加描述
    pService->start(); // 启动服务
    BLEDevice::startAdvertising();
}
