TYF009/Mini-Printer/(commit log)

2026-09-05 Add files via upload
    补充实体照片，以及项目流程
2026-09-05 Add files via upload
    添加坐标文件，BOM表以及原理图
    [Mini-Printer-BOM.xlsx]
2026-09-07 Add files via upload
    重新描述电源架构章节
