TYF009/Mini-Printer/docs/images/hardware-test-bench.jpg

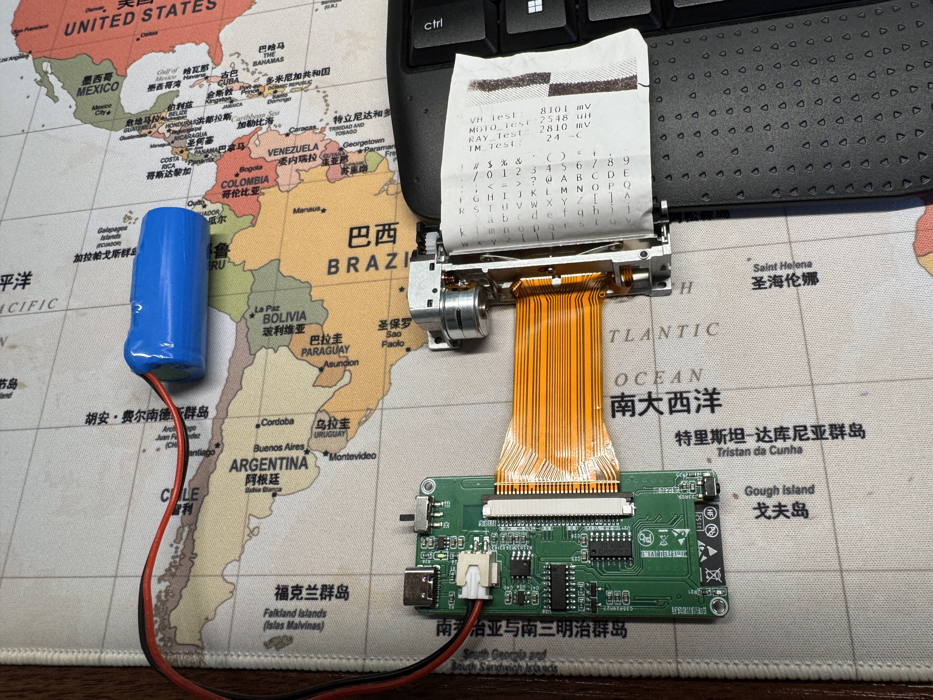
docs/images/hardware-test-bench.jpg
